FYDP-Group-31/PCBs/MCU_DAC_board/MCU_DAC_board.kicad_pcb

## KiCad design MCU_DAC_board/MCU_DAC_board.kicad_pcb (2025-07-11)

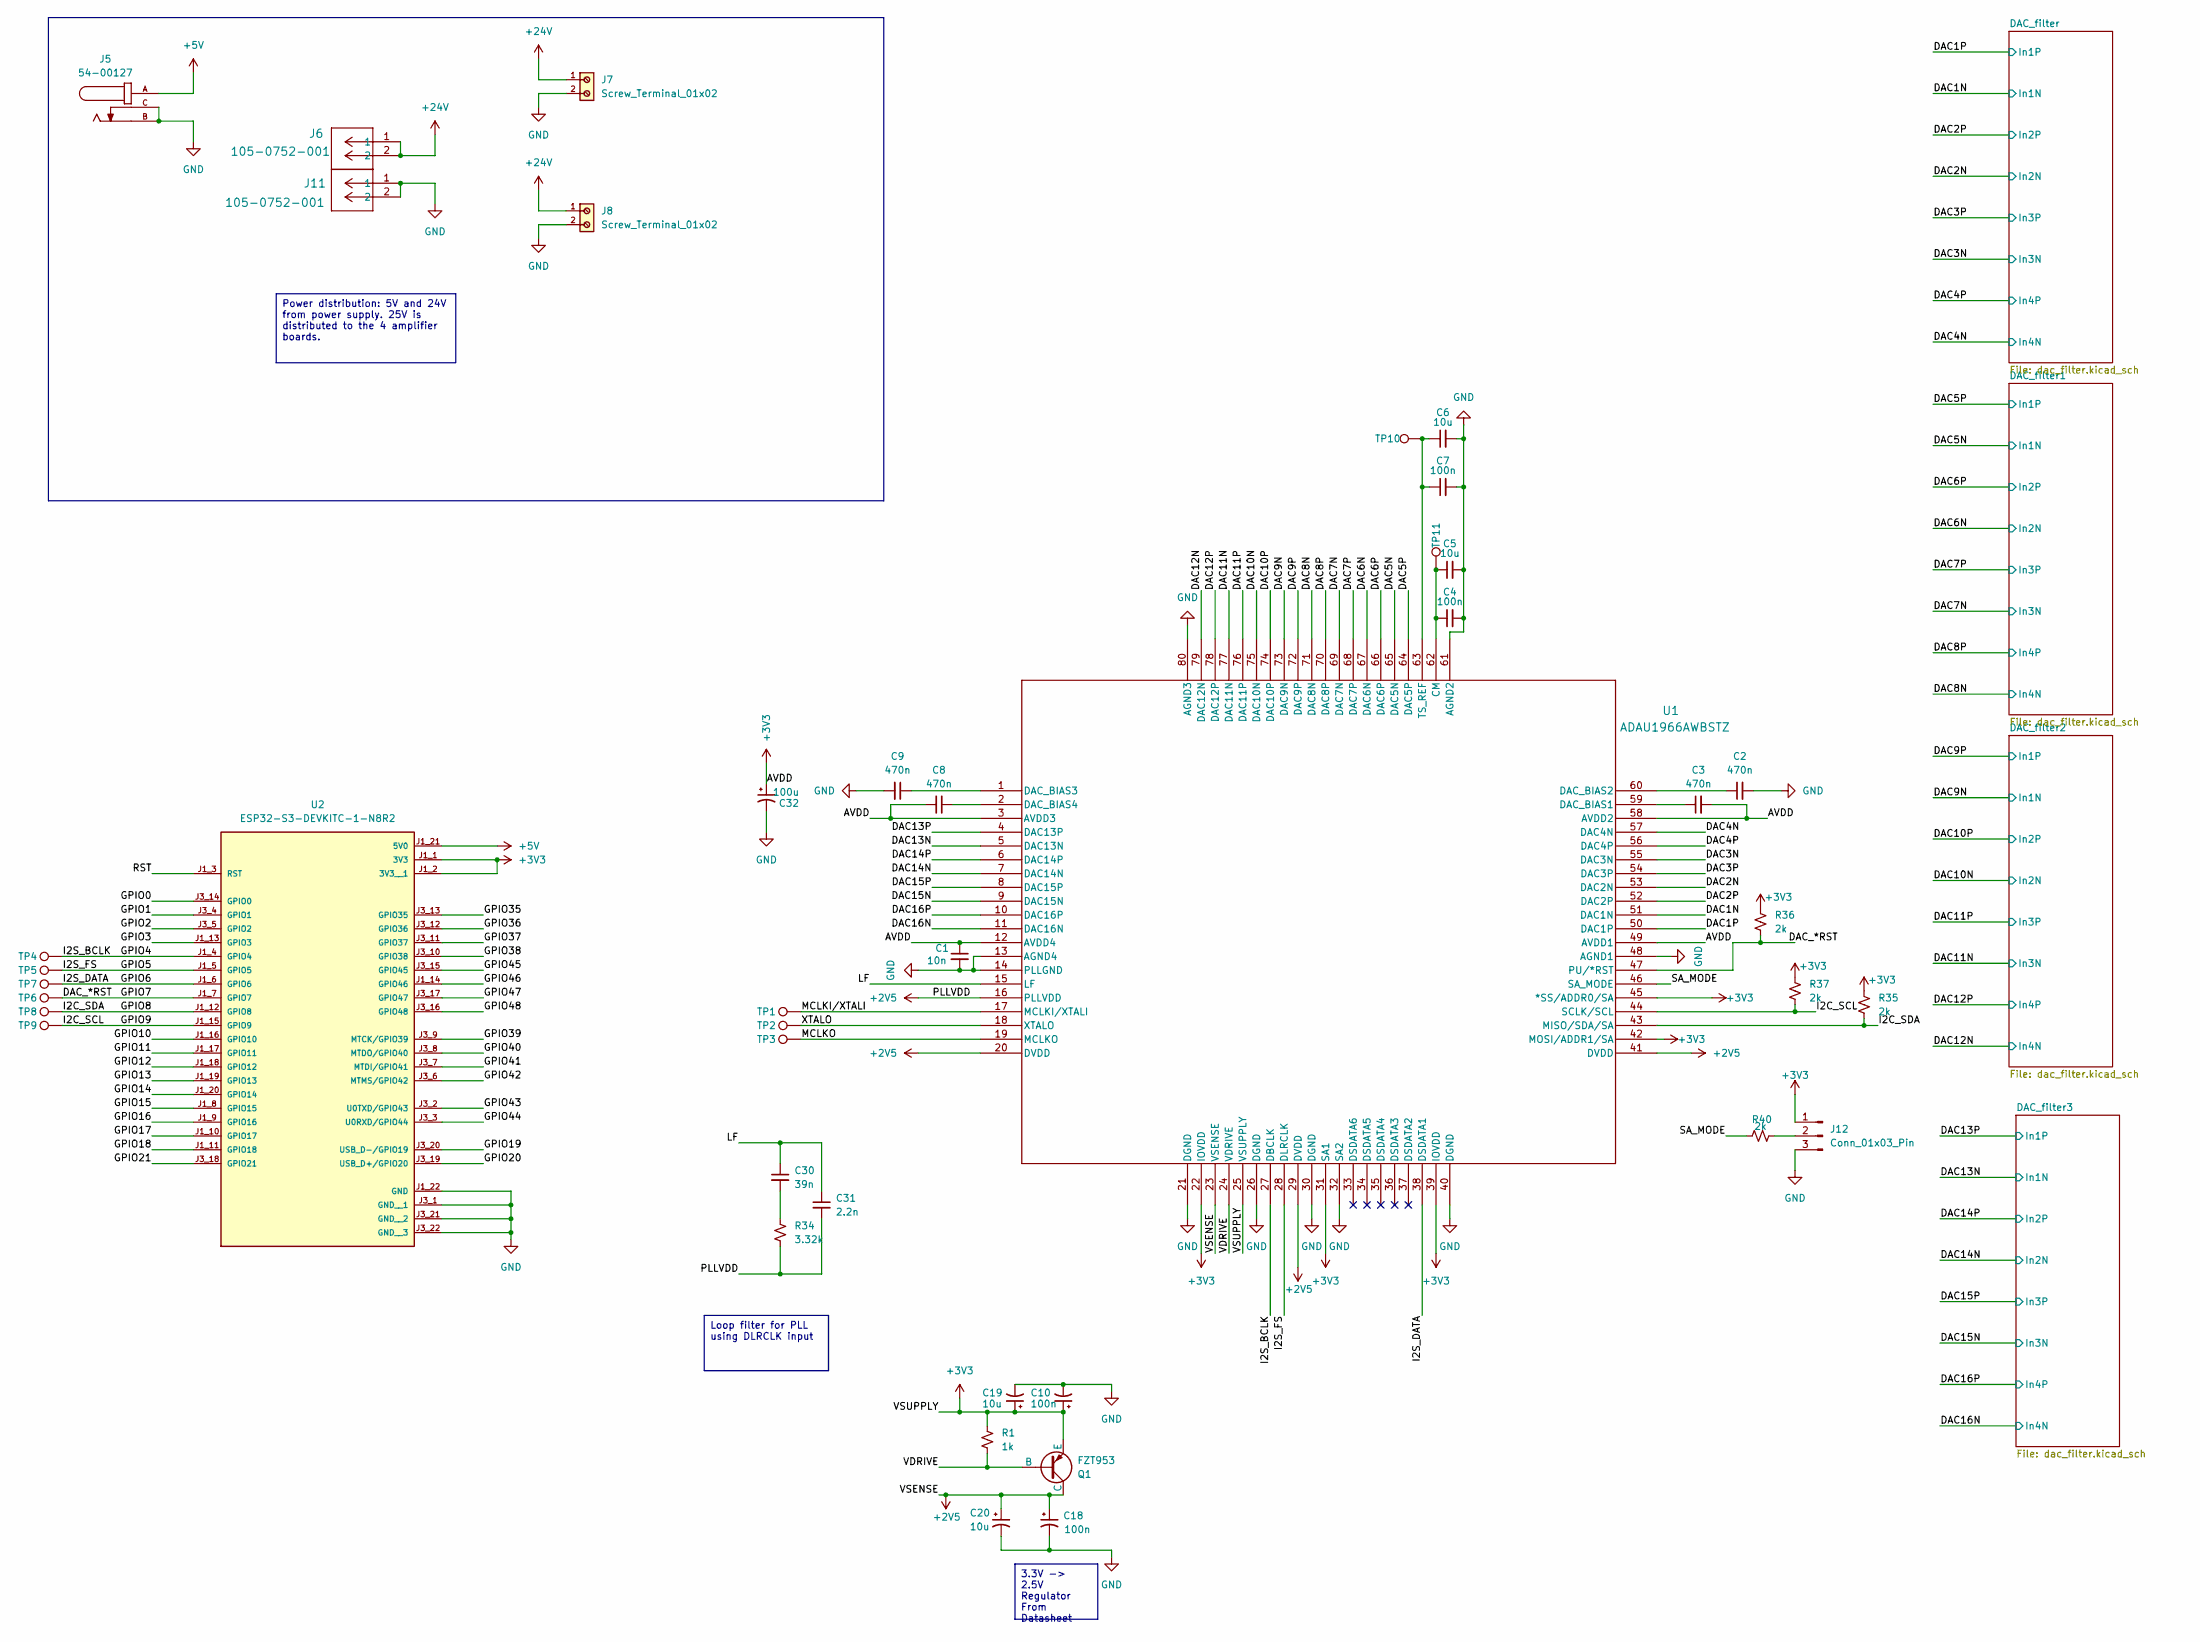
[picture p1: schematic MCU_DAC_board.kicad_sch]

Parts:
C1: 10n; C_0805_2012Metric_Pad1.18x1.45mm_HandSolder
C2, C3, C8, C9: 470n; C_0805_2012Metric_Pad1.18x1.45mm_HandSolder
C4, C7, C10, C18: 100n; C_0805_2012Metric_Pad1.18x1.45mm_HandSolder
C5, C6, C19, C20: 10u; C_0805_2012Metric_Pad1.18x1.45mm_HandSolder
C30: 39n; C_0805_2012Metric_Pad1.18x1.45mm_HandSolder
C31: 2.2n; C_0805_2012Metric_Pad1.18x1.45mm_HandSolder
C32: 100u; CP_Radial_D6.3mm_P2.50mm
J5: 54-00127; TENSILITY_54-00127; PARTREV A
J6, J11: 105-0752-001; CONN_0752-001
J7, J8: Screw_Terminal_01x02; 691137710002
J12: Conn_01x03_Pin; PinHeader_1x03_P2.54mm_Vertical
Q1: FZT953; SOT-223-3_TabPin2
R1: 1k; R_0805_2012Metric_Pad1.20x1.40mm_HandSolder
R34: 3.32k; R_0805_2012Metric_Pad1.20x1.40mm_HandSolder
R35, R36, R37, R40: 2k; R_0805_2012Metric_Pad1.20x1.40mm_HandSolder
TP1: MCLKI/XTALI; TP_1.8x1mm
TP2: XTALO; TP_1.8x1mm
TP3: MCLKO; TP_1.8x1mm
TP4: I2S_BCLK; TP_1.8x1mm
TP5: I2S_FS; TP_1.8x1mm
TP6: DAC_*RST; TP_1.8x1mm
TP7: I2S_DATA; TP_1.8x1mm
TP8: I2C_SDA; TP_1.8x1mm
TP9: I2C_SCL; TP_1.8x1mm
TP10: TS_REF; TP_1.8x1mm
TP11: CM; TP_1.8x1mm
U1: ADAU1966AWBSTZ; ST_80_2_ADI
U2: ESP32-S3-DEVKITC-1-N8R2; XCVR_ESP32-S3-DEVKITC-1-N8R2; PARTREV V1

Connections:
+2V5: C18.1, C20.1, C31.2, Q1.1 (C), R34.2, U1.16 (PLLVDD), U1.20 (DVDD), U1.23 (VSENSE), U1.29 (DVDD), U1.41 (DVDD)
+3V3: C1.1, C3.2, C8.2, C10.1, C19.1, C32.1, J12.1, Q1.3 (E), R1.1, R35.1, R36.1, R37.1, U1.3 (AVDD3), U1.12 (AVDD4), U1.22 (IOVDD), U1.25 (VSUPPLY), U1.31 (SA1), U1.39 (IOVDD), U1.42 (MOSI/ADDR1/SA), U1.45 (*SS/ADDR0/SA), U1.49 (AVDD1), U1.58 (AVDD2), U2.J1_1 (3V3), U2.J1_2 (3V3__1)
+5V: J5.A, U2.J1_21 (5V0)
+24V: J6.1, J6.2, J7.1, J8.1
/DAC1N: U1.51 (DAC1N); also elsewhere on the board
/DAC1P: U1.50 (DAC1P); also elsewhere on the board
/DAC2N: U1.53 (DAC2N); also elsewhere on the board
/DAC2P: U1.52 (DAC2P); also elsewhere on the board
/DAC3N: U1.55 (DAC3N); also elsewhere on the board
/DAC3P: U1.54 (DAC3P); also elsewhere on the board
/DAC4N: U1.57 (DAC4N); also elsewhere on the board
/DAC4P: U1.56 (DAC4P); also elsewhere on the board
/DAC5N: U1.65 (DAC5N); also elsewhere on the board
/DAC5P: U1.64 (DAC5P); also elsewhere on the board
/DAC6N: U1.67 (DAC6N); also elsewhere on the board
/DAC6P: U1.66 (DAC6P); also elsewhere on the board
/DAC7N: U1.69 (DAC7N); also elsewhere on the board
/DAC7P: U1.68 (DAC7P); also elsewhere on the board
/DAC8N: U1.71 (DAC8N); also elsewhere on the board
/DAC8P: U1.70 (DAC8P); also elsewhere on the board
/DAC9N: U1.73 (DAC9N); also elsewhere on the board
/DAC9P: U1.72 (DAC9P); also elsewhere on the board
/DAC10N: U1.75 (DAC10N); also elsewhere on the board
/DAC10P: U1.74 (DAC10P); also elsewhere on the board
/DAC11N: U1.77 (DAC11N); also elsewhere on the board
/DAC11P: U1.76 (DAC11P); also elsewhere on the board
/DAC12N: U1.79 (DAC12N); also elsewhere on the board
/DAC12P: U1.78 (DAC12P); also elsewhere on the board
/DAC13N: U1.5 (DAC13N); also elsewhere on the board
/DAC13P: U1.4 (DAC13P); also elsewhere on the board
/DAC14N: U1.7 (DAC14N); also elsewhere on the board
/DAC14P: U1.6 (DAC14P); also elsewhere on the board
/DAC15N: U1.9 (DAC15N); also elsewhere on the board
/DAC15P: U1.8 (DAC15P); also elsewhere on the board
/DAC16N: U1.11 (DAC16N); also elsewhere on the board
/DAC16P: U1.10 (DAC16P); also elsewhere on the board
/DAC_*RST: R36.2, TP6.1, U1.47 (PU/*RST), U2.J1_7 (GPIO7)
/GPIO0: U2.J3_14 (GPIO0)
/GPIO1: U2.J3_4 (GPIO1)
/GPIO2: U2.J3_5 (GPIO2)
/GPIO3: U2.J1_13 (GPIO3)
/GPIO4: TP4.1, U1.27 (DBCLK), U2.J1_4 (GPIO4)
/GPIO5: TP5.1, U1.28 (DLRCLK), U2.J1_5 (GPIO5)
/GPIO6: TP7.1, U1.38 (DSDATA1), U2.J1_6 (GPIO6)
/GPIO8: R35.2, TP8.1, U1.43 (MISO/SDA/SA), U2.J1_12 (GPIO8)
/GPIO9: R37.2, TP9.1, U1.44 (SCLK/SCL), U2.J1_15 (GPIO9)
/GPIO10: U2.J1_16 (GPIO10)
/GPIO11: U2.J1_17 (GPIO11)
/GPIO12: U2.J1_18 (GPIO12)
/GPIO13: U2.J1_19 (GPIO13)
/GPIO14: U2.J1_20 (GPIO14)
/GPIO15: U2.J1_8 (GPIO15)
/GPIO16: U2.J1_9 (GPIO16)
/GPIO17: U2.J1_10 (GPIO17)
/GPIO18: U2.J1_11 (GPIO18)
/GPIO19: U2.J3_20 (USB_D-/GPIO19)
/GPIO20: U2.J3_19 (USB_D+/GPIO20)
/GPIO21: U2.J3_18 (GPIO21)
/GPIO35: U2.J3_13 (GPIO35)
/GPIO36: U2.J3_12 (GPIO36)
/GPIO37: U2.J3_11 (GPIO37)
/GPIO38: U2.J3_10 (GPIO38)
/GPIO39: U2.J3_9 (MTCK/GPIO39)
/GPIO40: U2.J3_8 (MTDO/GPIO40)
/GPIO41: U2.J3_7 (MTDI/GPIO41)
/GPIO42: U2.J3_6 (MTMS/GPIO42)
/GPIO43: U2.J3_2 (U0TXD/GPIO43)
/GPIO44: U2.J3_3 (U0RXD/GPIO44)
/GPIO45: U2.J3_15 (GPIO45)
/GPIO46: U2.J1_14 (GPIO46)
/GPIO47: U2.J3_17 (GPIO47)
/GPIO48: U2.J3_16 (GPIO48)
/LF: C30.1, C31.1, U1.15 (LF)
/MCLKI/XTALI: TP1.1, U1.17 (MCLKI/XTALI)
/MCLKO: TP3.1, U1.19 (MCLKO)
/RST: U2.J1_3 (RST)
/SA_MODE: R40.1, U1.46 (SA_MODE)
/VDRIVE: Q1.2 (B), R1.2, U1.24 (VDRIVE)
/XTALO: TP2.1, U1.18 (XTALO)
GND: C1.2, C2.2, C4.2, C5.2, C6.2, C7.2, C9.2, C10.2, C18.2, C19.2, C20.2, C32.2, J5.B, J5.C, J7.2, J8.2, J11.1, J11.2, J12.3, U1.13 (AGND4), U1.14 (PLLGND), U1.21 (DGND), U1.26 (DGND), U1.30 (DGND), U1.32 (SA2), U1.40 (DGND), U1.48 (AGND1), U1.61 (AGND2), U1.80 (AGND3), U2.J1_22 (GND), U2.J3_1 (GND__1), U2.J3_21 (GND__2), U2.J3_22 (GND__3)
unnamed: C30.2, R34.1
unnamed: J12.2, R40.2
unnamed: C4.1, C5.1, TP11.1, U1.62 (CM)
unnamed: C3.1, U1.59 (DAC_BIAS1)
unnamed: C2.1, U1.60 (DAC_BIAS2)
unnamed: C9.1, U1.1 (DAC_BIAS3)
unnamed: C8.1, U1.2 (DAC_BIAS4)
unnamed: C6.1, C7.1, TP10.1, U1.63 (TS_REF)

Notes on the sheet:
3.3V -> 2.5V Regulator From Datasheet
Loop filter for PLL using DLRCLK input
Power distribution: 5V and 24V from power supply. 25V is distributed to the 4 amplifier boards.

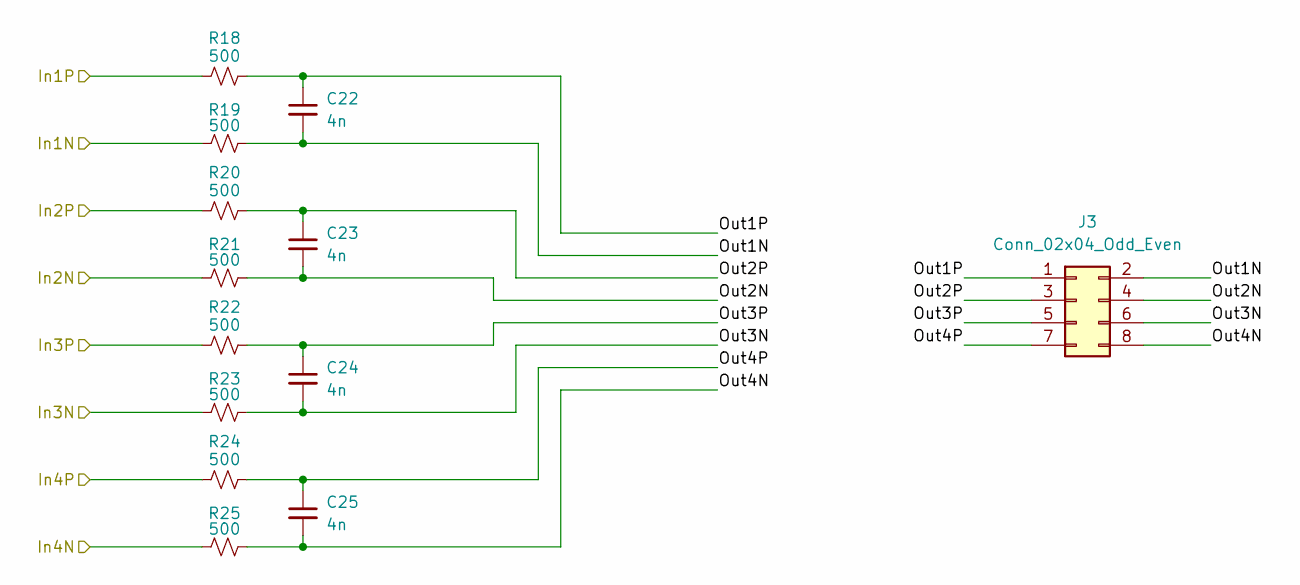
[picture p2: schematic dac_filter.kicad_sch]

Parts:
C22, C23, C24, C25: 4n; C_0805_2012Metric_Pad1.18x1.45mm_HandSolder
J3: Conn_02x04_Odd_Even; BHR-08-VUA
R18, R19, R20, R21, R22, R23, R24, R25: 500; R_0805_2012Metric_Pad1.20x1.40mm_HandSolder

Connections:
/DAC9N: R19.1; also elsewhere on the board
/DAC9P: R18.1; also elsewhere on the board
/DAC10N: R21.1; also elsewhere on the board
/DAC10P: R20.1; also elsewhere on the board
/DAC11N: R23.1; also elsewhere on the board
/DAC11P: R22.1; also elsewhere on the board
/DAC12N: R25.1; also elsewhere on the board
/DAC12P: R24.1; also elsewhere on the board
/DAC_filter2/Out1N: C22.2, J3.2, R19.2
/DAC_filter2/Out1P: C22.1, J3.1, R18.2
/DAC_filter2/Out2N: C23.2, J3.4, R21.2
/DAC_filter2/Out2P: C23.1, J3.3, R20.2
/DAC_filter2/Out3N: C24.2, J3.6, R23.2
/DAC_filter2/Out3P: C24.1, J3.5, R22.2
/DAC_filter2/Out4N: C25.2, J3.8, R25.2
/DAC_filter2/Out4P: C25.1, J3.7, R24.2

Parts of its further copies:
C11, C12, C13, C14, C15, C16, C17, C21, C26, C27, C28, C29: 4n; C_0805_2012Metric_Pad1.18x1.45mm_HandSolder
J1, J2, J4: Conn_02x04_Odd_Even; BHR-08-VUA
R2, R3, R4, R5, R6, R7, R8, R9, R10, R11, R12, R13, R14, R15, R16, R17, R26, R27, R28, R29, R30, R31, R32, R33: 500; R_0805_2012Metric_Pad1.20x1.40mm_HandSolder

Connections of its further copies:
/DAC1N: R3.1; also elsewhere on the board
/DAC1P: R2.1; also elsewhere on the board
/DAC2N: R5.1; also elsewhere on the board
/DAC2P: R4.1; also elsewhere on the board
/DAC3N: R7.1; also elsewhere on the board
/DAC3P: R6.1; also elsewhere on the board
/DAC4N: R9.1; also elsewhere on the board
/DAC4P: R8.1; also elsewhere on the board
/DAC5N: R11.1; also elsewhere on the board
/DAC5P: R10.1; also elsewhere on the board
/DAC6N: R13.1; also elsewhere on the board
/DAC6P: R12.1; also elsewhere on the board
/DAC7N: R15.1; also elsewhere on the board
/DAC7P: R14.1; also elsewhere on the board
/DAC8N: R17.1; also elsewhere on the board
/DAC8P: R16.1; also elsewhere on the board
/DAC13N: R27.1; also elsewhere on the board
/DAC13P: R26.1; also elsewhere on the board
/DAC14N: R29.1; also elsewhere on the board
/DAC14P: R28.1; also elsewhere on the board
/DAC15N: R31.1; also elsewhere on the board
/DAC15P: R30.1; also elsewhere on the board
/DAC16N: R33.1; also elsewhere on the board
/DAC16P: R32.1; also elsewhere on the board
/DAC_filter1/Out1N: C15.2, J2.2, R11.2
/DAC_filter1/Out1P: C15.1, J2.1, R10.2
/DAC_filter1/Out2N: C16.2, J2.4, R13.2
/DAC_filter1/Out2P: C16.1, J2.3, R12.2
/DAC_filter1/Out3N: C17.2, J2.6, R15.2
/DAC_filter1/Out3P: C17.1, J2.5, R14.2
/DAC_filter1/Out4N: C21.2, J2.8, R17.2
/DAC_filter1/Out4P: C21.1, J2.7, R16.2
/DAC_filter3/Out1N: C26.2, J4.2, R27.2
/DAC_filter3/Out1P: C26.1, J4.1, R26.2
/DAC_filter3/Out2N: C27.2, J4.4, R29.2
/DAC_filter3/Out2P: C27.1, J4.3, R28.2
/DAC_filter3/Out3N: C28.2, J4.6, R31.2
/DAC_filter3/Out3P: C28.1, J4.5, R30.2
/DAC_filter3/Out4N: C29.2, J4.8, R33.2
/DAC_filter3/Out4P: C29.1, J4.7, R32.2
/DAC_filter/Out1N: C11.2, J1.2, R3.2
/DAC_filter/Out1P: C11.1, J1.1, R2.2
/DAC_filter/Out2N: C12.2, J1.4, R5.2
/DAC_filter/Out2P: C12.1, J1.3, R4.2
/DAC_filter/Out3N: C13.2, J1.6, R7.2
/DAC_filter/Out3P: C13.1, J1.5, R6.2
/DAC_filter/Out4N: C14.2, J1.8, R9.2
/DAC_filter/Out4P: C14.1, J1.7, R8.2

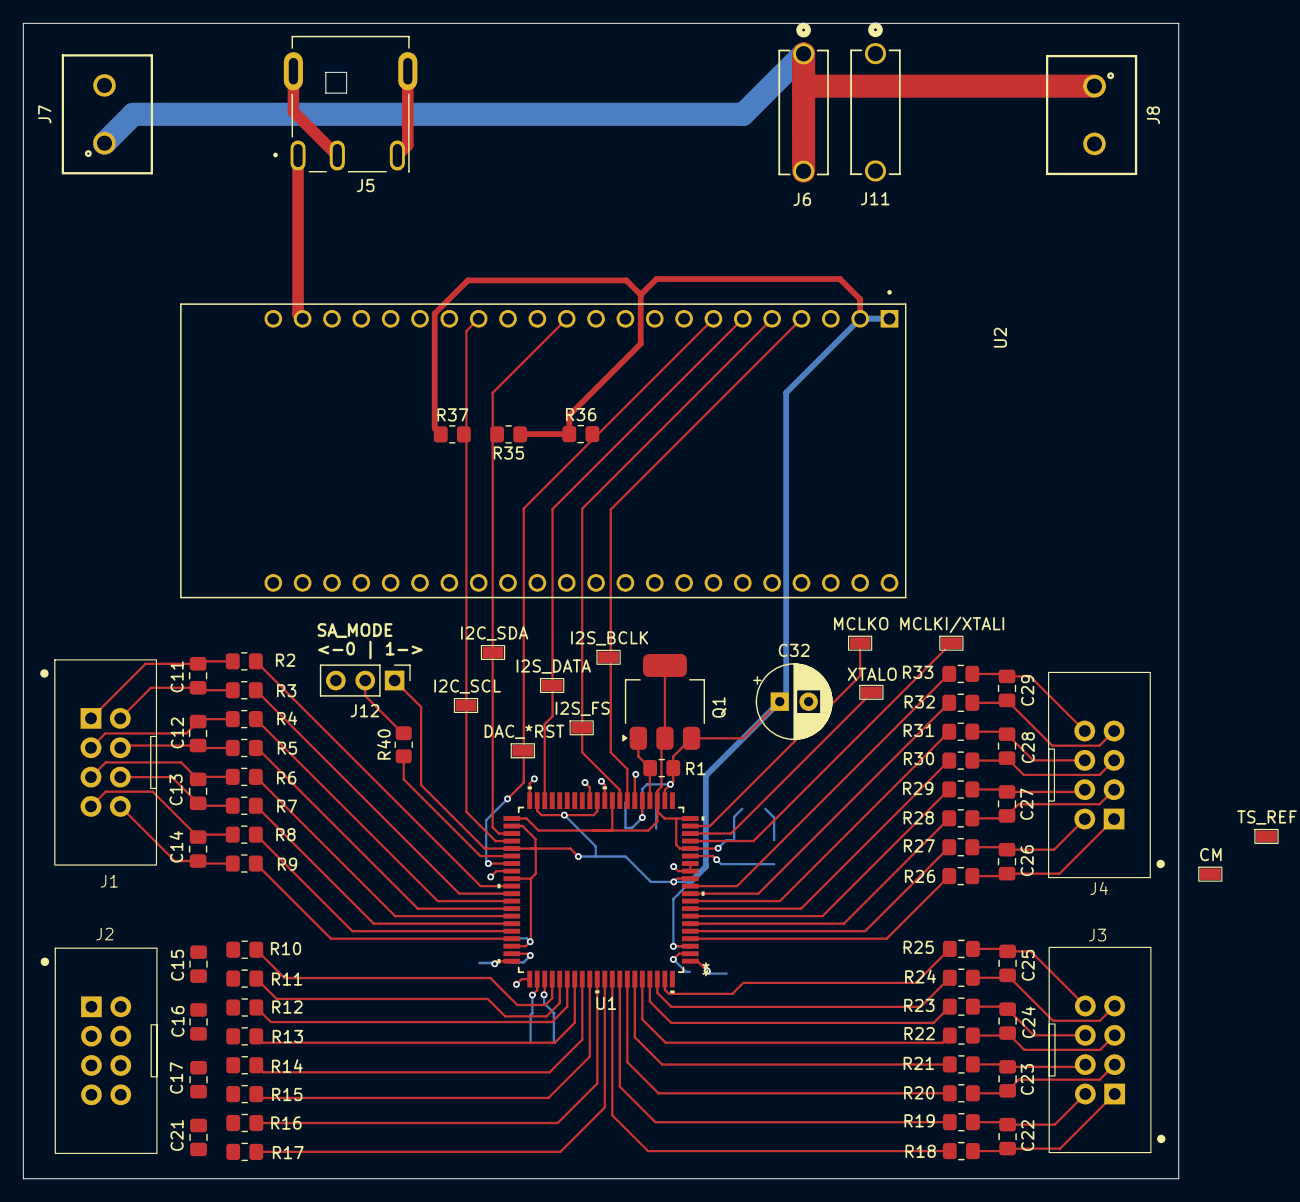
[picture p3: board MCU_DAC_board.kicad_pcb from above]

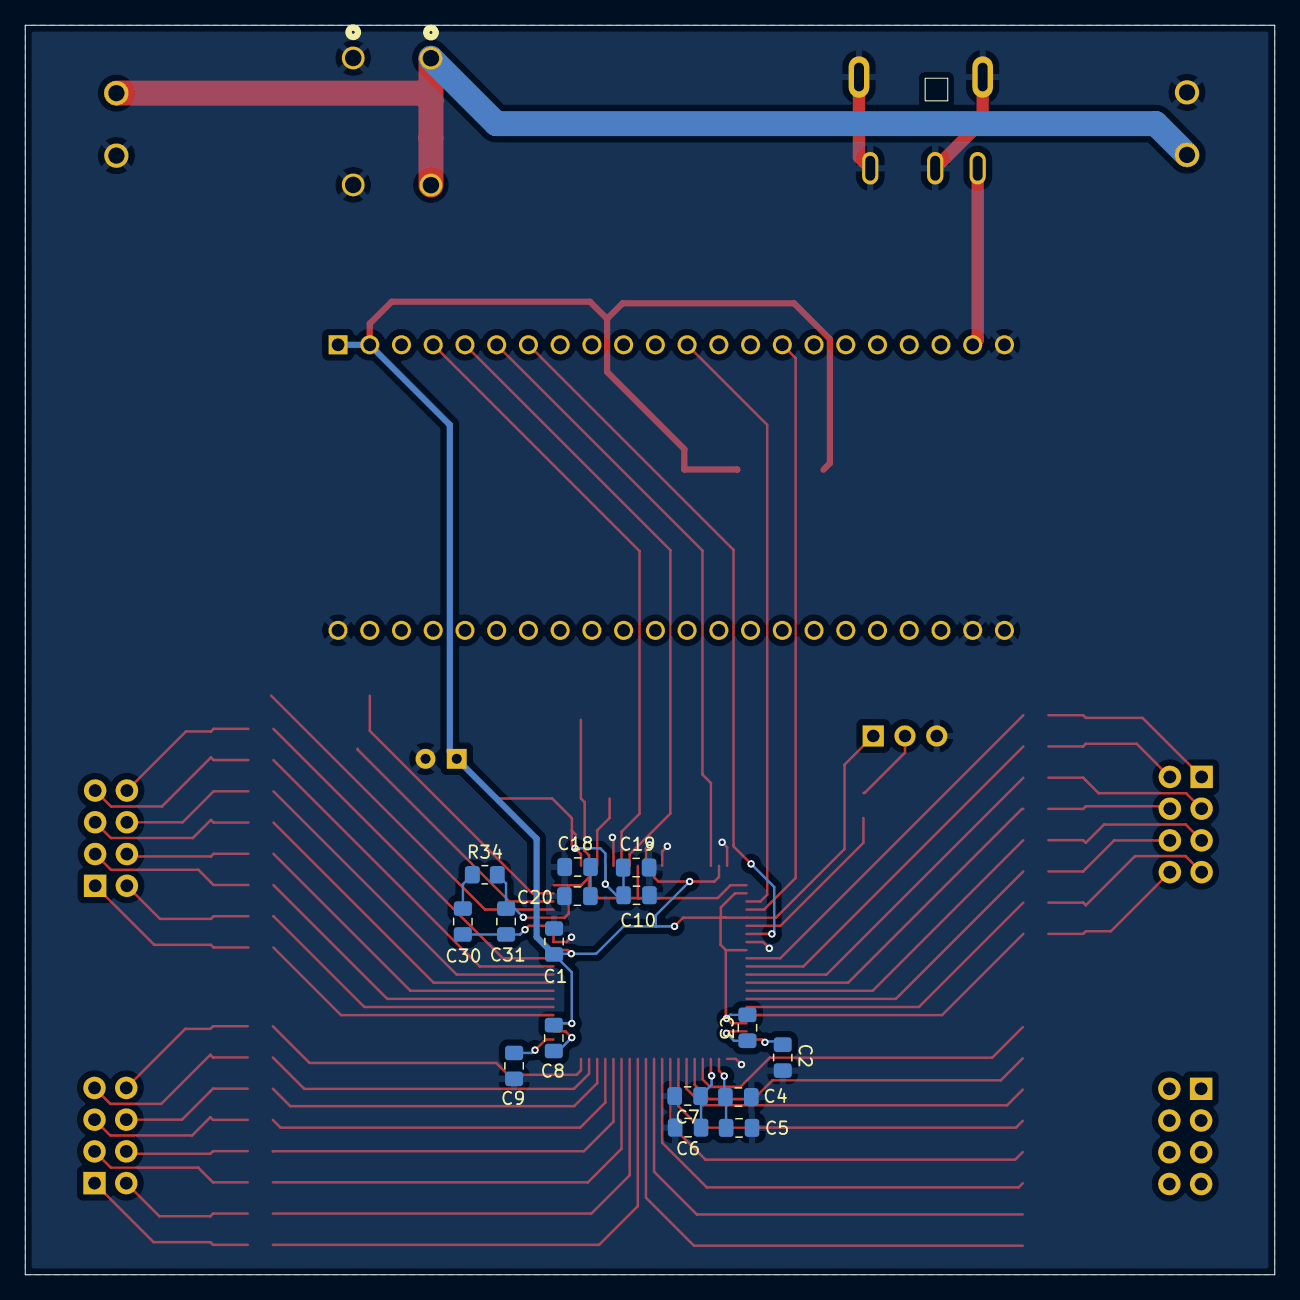
[picture p4: board MCU_DAC_board.kicad_pcb from below]

Board: 2 copper layers, 100.0 x 100.0 mm, 94 parts (16 on the bottom side), 89 nets.
