FYDP-Group-31/PCBs/Amplifier_board/Amplifier_board.kicad_pcb

## KiCad design Amplifier_board/Amplifier_board.kicad_pcb (2025-07-10)

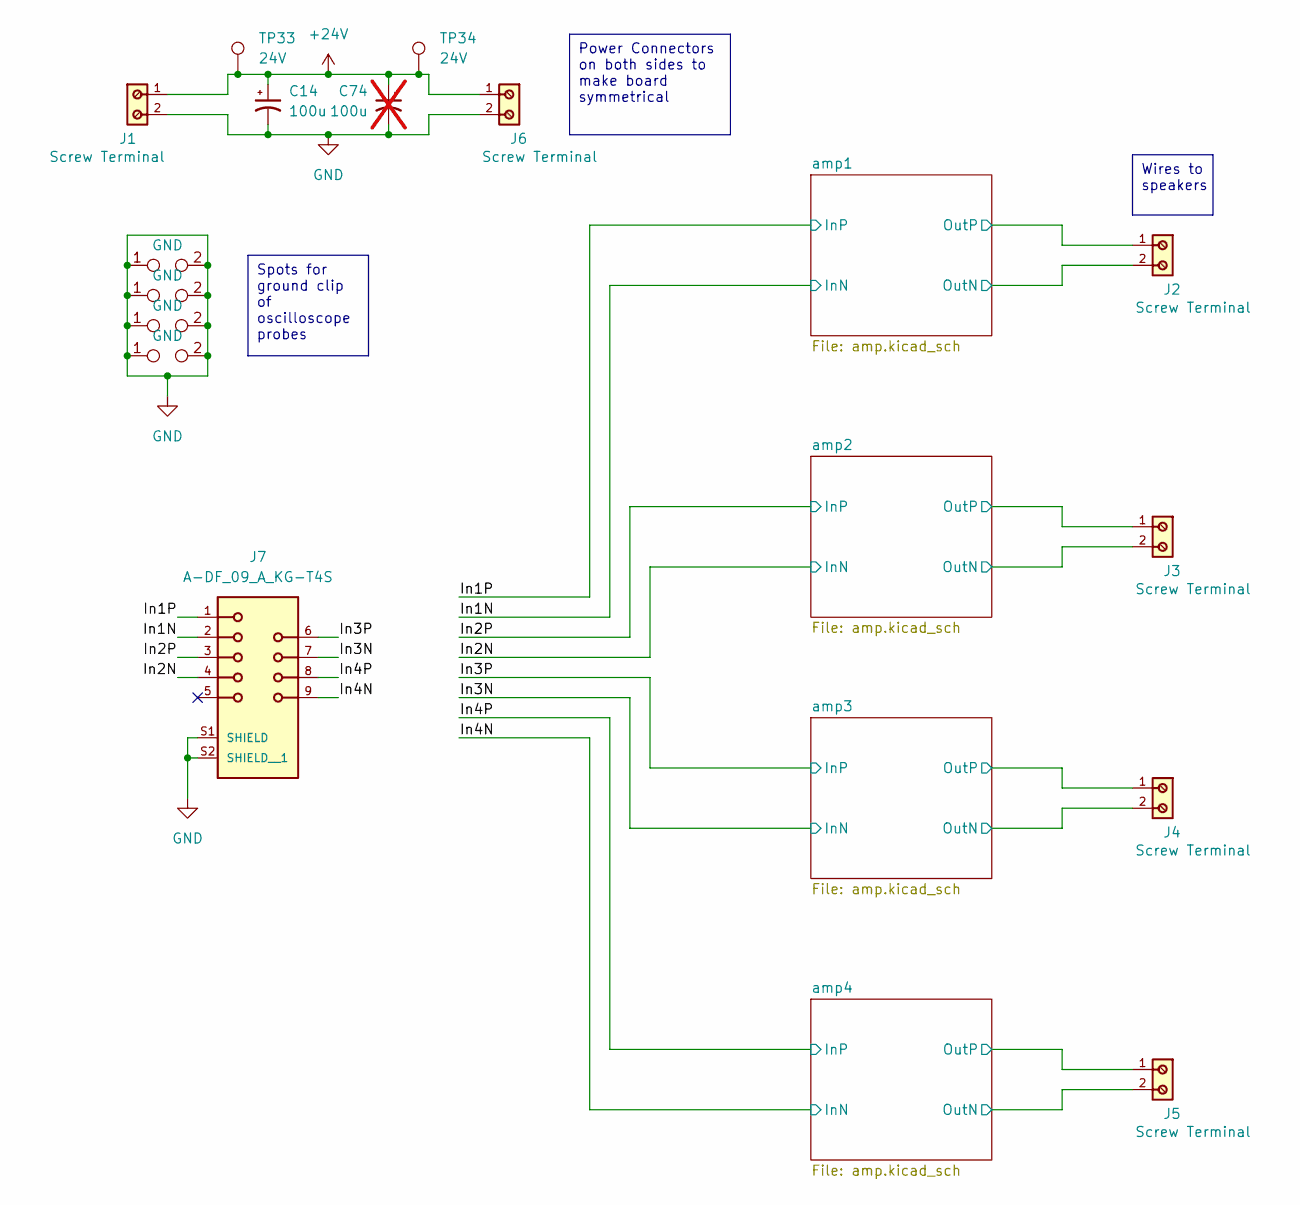
[picture p5: schematic Amplifier_board.kicad_sch]

Parts:
C14: 100u; CP_Radial_D6.3mm_P2.50mm
C74: 100u; CP_Radial_D6.3mm_P2.50mm; not fitted
J1, J2, J3, J4, J5, J6: Screw Terminal; 691137710002
J7: A-DF_09_A_KG-T4S; ASSMANN_A-DF_09_A_KG-T4S; PARTREV 05
TP33, TP34: 24V; TP_RCUCTE
TP35, TP36, TP37, TP38: GND; TestPoint_Bridge_Pitch5.08mm_Drill0.7mm

Connections:
+24V: C14.1, C74.1, J1.1, J6.1, TP33.1, TP34.1; also elsewhere on the board
/In1N: J7.2; also elsewhere on the board
/In1P: J7.1; also elsewhere on the board
/In2N: J7.4; also elsewhere on the board
/In2P: J7.3; also elsewhere on the board
/In3N: J7.7; also elsewhere on the board
/In3P: J7.6; also elsewhere on the board
/In4N: J7.9; also elsewhere on the board
/In4P: J7.8; also elsewhere on the board
/amp1/OutN: J2.2; also elsewhere on the board
/amp1/OutP: J2.1; also elsewhere on the board
/amp2/OutN: J3.2; also elsewhere on the board
/amp2/OutP: J3.1; also elsewhere on the board
/amp3/OutN: J4.2; also elsewhere on the board
/amp3/OutP: J4.1; also elsewhere on the board
/amp4/OutN: J5.2; also elsewhere on the board
/amp4/OutP: J5.1; also elsewhere on the board
GND: C14.2, C74.2, J1.2, J6.2, J7.S1 (SHIELD), J7.S2 (SHIELD__1), TP35.1, TP35.2, TP36.1, TP36.2, TP37.1, TP37.2, TP38.1, TP38.2; also elsewhere on the board

Notes on the sheet:
Wires to speakers
Spots for ground clip of oscilloscope probes
Power Connectors on both sides to make board symmetrical

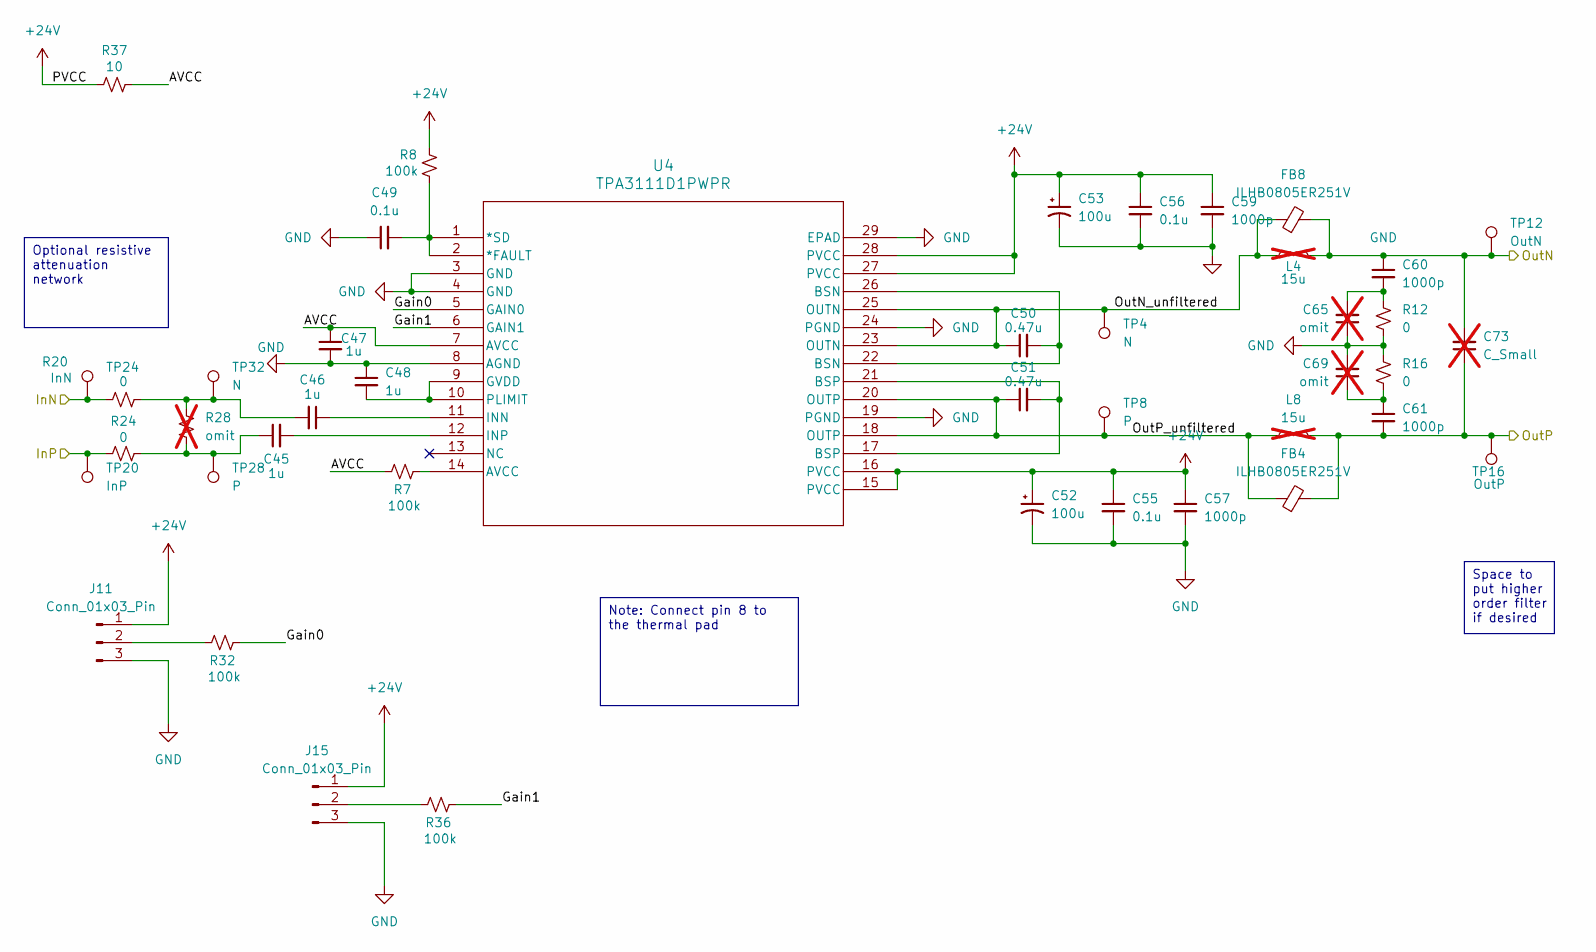
[picture p6: schematic amp.kicad_sch]

Parts:
C45, C46, C47, C48: 1u; C_0805_2012Metric_Pad1.18x1.45mm_HandSolder
C49, C55, C56: 0.1u; C_0805_2012Metric_Pad1.18x1.45mm_HandSolder
C50, C51: 0.47u; C_0805_2012Metric_Pad1.18x1.45mm_HandSolder
C52, C53: 100u; CP_Radial_D6.3mm_P2.50mm
C57, C59, C60, C61: 1000p; C_0805_2012Metric_Pad1.18x1.45mm_HandSolder
C65, C69: omit; C_0805_2012Metric_Pad1.18x1.45mm_HandSolder; not fitted
C73: C_Small; C_0805_2012Metric_Pad1.18x1.45mm_HandSolder; not fitted
FB4, FB8: ILHB0805ER251V; L_0805_2012Metric_Pad1.15x1.40mm_HandSolder
J11, J15: Conn_01x03_Pin; PinSocket_1x03_P2.54mm_Vertical
L4, L8: 15u; L_Taiyo-Yuden_NR-50xx_HandSoldering; not fitted
R7, R8, R32, R36: 100k; R_0805_2012Metric_Pad1.20x1.40mm_HandSolder
R12, R16, R20, R24: 0; R_0805_2012Metric_Pad1.20x1.40mm_HandSolder
R28: omit; R_0805_2012Metric_Pad1.20x1.40mm_HandSolder; not fitted
R37: 10; C_0805_2012Metric_Pad1.18x1.45mm_HandSolder
TP4, TP32: N; TP_RCUCTE
TP8, TP28: P; TP_RCUCTE
TP12: OutN; TP_RCUCTE
TP16: OutP; TP_RCUCTE
TP20: InP; TP_RCUCTE
TP24: InN; TP_RCUCTE
U4: TPA3111D1PWPR; PWP28_6P17X2P4

Connections:
+24V: C52.1, C53.1, C55.1, C56.1, C57.1, C59.1, J11.1, J15.1, R8.1, R37.1, U4.15 (PVCC), U4.16 (PVCC), U4.27 (PVCC), U4.28 (PVCC); also elsewhere on the board
/In4N: R20.2, TP24.1; also elsewhere on the board
/In4P: R24.2, TP20.1; also elsewhere on the board
/amp4/Gain0: R32.2, U4.5 (GAIN0)
/amp4/Gain1: R36.2, U4.6 (GAIN1)
/amp4/OutN: C60.1, C73.2, FB8.2, L4.2, TP12.1; also elsewhere on the board
/amp4/OutN_unfiltered: C50.1, FB8.1, L4.1, TP4.1, U4.23 (OUTN), U4.25 (OUTN)
/amp4/OutP: C61.2, C73.1, FB4.2, L8.2, TP16.1; also elsewhere on the board
/amp4/OutP_unfiltered: C51.1, FB4.1, L8.1, TP8.1, U4.18 (OUTP), U4.20 (OUTP)
GND: C47.2, C48.1, C49.1, C52.2, C53.2, C55.2, C56.2, C57.2, C59.2, C65.1, C69.2, J11.3, J15.3, R12.1, R16.2, U4.3 (GND), U4.4 (GND), U4.8 (AGND), U4.19 (PGND), U4.24 (PGND), U4.29 (EPAD); also elsewhere on the board
unnamed: C45.1, R24.1, R28.2, TP28.1
unnamed: C46.2, R20.1, R28.1, TP32.1
unnamed: C50.2, U4.22 (BSN), U4.26 (BSN)
unnamed: C51.2, U4.17 (BSP), U4.21 (BSP)
unnamed: C60.2, C65.2, R12.2
unnamed: C61.1, C69.1, R16.1
unnamed: J11.2, R32.1
unnamed: J15.2, R36.1
unnamed: R7.2, U4.14 (AVCC)
unnamed: C49.2, R8.2, U4.1 (*SD), U4.2 (*FAULT)
unnamed: C48.2, U4.9 (GVDD), U4.10 (PLIMIT)
unnamed: C46.1, U4.11 (INN)
unnamed: C45.2, U4.12 (INP)

Parts of its further copies:
C1, C2, C3, C4, C15, C16, C17, C18, C30, C31, C32, C33: 1u; C_0805_2012Metric_Pad1.18x1.45mm_HandSolder
C5, C10, C11, C19, C24, C25, C34, C39, C40: 0.1u; C_0805_2012Metric_Pad1.18x1.45mm_HandSolder
C6, C7, C20, C21, C35, C36: 0.47u; C_0805_2012Metric_Pad1.18x1.45mm_HandSolder
C8, C9, C22, C23, C37, C38: 100u; CP_Radial_D6.3mm_P2.50mm
C12, C13, C26, C27, C28, C29, C41, C42, C43, C44, C54, C58: 1000p; C_0805_2012Metric_Pad1.18x1.45mm_HandSolder
C62, C63, C64, C66, C67, C68: omit; C_0805_2012Metric_Pad1.18x1.45mm_HandSolder; not fitted
C70, C71, C72: C_Small; C_0805_2012Metric_Pad1.18x1.45mm_HandSolder; not fitted
FB1, FB2, FB3, FB5, FB6, FB7: ILHB0805ER251V; L_0805_2012Metric_Pad1.15x1.40mm_HandSolder
J8, J9, J10, J12, J13, J14: Conn_01x03_Pin; PinSocket_1x03_P2.54mm_Vertical
L1, L2, L3, L5, L6, L7: 15u; L_Taiyo-Yuden_NR-50xx_HandSoldering; not fitted
R1, R2, R3, R4, R5, R6, R29, R30, R31, R33, R34, R35: 100k; R_0805_2012Metric_Pad1.20x1.40mm_HandSolder
R9, R10, R11, R13, R14, R15, R17, R18, R19, R21, R22, R23: 0; R_0805_2012Metric_Pad1.20x1.40mm_HandSolder
R25, R26, R27: omit; R_0805_2012Metric_Pad1.20x1.40mm_HandSolder; not fitted
R38, R39, R40: 10; C_0805_2012Metric_Pad1.18x1.45mm_HandSolder
TP1, TP2, TP3, TP29, TP30, TP31: N; TP_RCUCTE
TP5, TP6, TP7, TP25, TP26, TP27: P; TP_RCUCTE
TP9, TP10, TP11: OutN; TP_RCUCTE
TP13, TP14, TP15: OutP; TP_RCUCTE
TP17, TP18, TP19: InP; TP_RCUCTE
TP21, TP22, TP23: InN; TP_RCUCTE
U1, U2, U3: TPA3111D1PWPR; PWP28_6P17X2P4

Connections of its further copies:
+24V: C8.1, C9.1, C10.1, C11.1, C12.1, C13.1, C22.1, C23.1, C24.1, C25.1, C26.1, C27.1, C37.1, C38.1, C39.1, C40.1, C41.1, C42.1, J8.1, J9.1, J10.1, J12.1, J13.1, J14.1, R2.1, R4.1, R6.1, R38.1, R39.1, R40.1, U1.15 (PVCC), U1.16 (PVCC), U1.27 (PVCC), U1.28 (PVCC), U2.15 (PVCC), U2.16 (PVCC), U2.27 (PVCC), U2.28 (PVCC), U3.15 (PVCC), U3.16 (PVCC), U3.27 (PVCC), U3.28 (PVCC); also elsewhere on the board
/In1N: R17.2, TP21.1; also elsewhere on the board
/In1P: R21.2, TP17.1; also elsewhere on the board
/In2N: R18.2, TP22.1; also elsewhere on the board
/In2P: R22.2, TP18.1; also elsewhere on the board
/In3N: R19.2, TP23.1; also elsewhere on the board
/In3P: R23.2, TP19.1; also elsewhere on the board
/amp1/Gain0: R29.2, U1.5 (GAIN0)
/amp1/Gain1: R33.2, U1.6 (GAIN1)
/amp1/OutN: C54.1, C70.2, FB5.2, L1.2, TP9.1; also elsewhere on the board
/amp1/OutN_unfiltered: C6.1, FB5.1, L1.1, TP1.1, U1.23 (OUTN), U1.25 (OUTN)
/amp1/OutP: C58.2, C70.1, FB1.2, L5.2, TP13.1; also elsewhere on the board
/amp1/OutP_unfiltered: C7.1, FB1.1, L5.1, TP5.1, U1.18 (OUTP), U1.20 (OUTP)
/amp2/AVCC: C17.1, R3.1, R38.2, U2.7 (AVCC)
/amp2/Gain0: R30.2, U2.5 (GAIN0)
/amp2/Gain1: R34.2, U2.6 (GAIN1)
/amp2/OutN: C28.1, C71.2, FB6.2, L2.2, TP10.1; also elsewhere on the board
/amp2/OutN_unfiltered: C20.1, FB6.1, L2.1, TP2.1, U2.23 (OUTN), U2.25 (OUTN)
/amp2/OutP: C29.2, C71.1, FB2.2, L6.2, TP14.1; also elsewhere on the board
/amp2/OutP_unfiltered: C21.1, FB2.1, L6.1, TP6.1, U2.18 (OUTP), U2.20 (OUTP)
/amp3/AVCC: C32.1, R5.1, R39.2, U3.7 (AVCC)
/amp3/Gain0: R31.2, U3.5 (GAIN0)
/amp3/Gain1: R35.2, U3.6 (GAIN1)
/amp3/OutN: C43.1, C72.2, FB7.2, L3.2, TP11.1; also elsewhere on the board
/amp3/OutN_unfiltered: C35.1, FB7.1, L3.1, TP3.1, U3.23 (OUTN), U3.25 (OUTN)
/amp3/OutP: C44.2, C72.1, FB3.2, L7.2, TP15.1; also elsewhere on the board
/amp3/OutP_unfiltered: C36.1, FB3.1, L7.1, TP7.1, U3.18 (OUTP), U3.20 (OUTP)
GND: C3.2, C4.1, C5.1, C8.2, C9.2, C10.2, C11.2, C12.2, C13.2, C17.2, C18.1, C19.1, C22.2, C23.2, C24.2, C25.2, C26.2, C27.2, C32.2, C33.1, C34.1, C37.2, C38.2, C39.2, C40.2, C41.2, C42.2, C62.1, C63.1, C64.1, C66.2, C67.2, C68.2, J8.3, J9.3, J10.3, J12.3, J13.3, J14.3, R9.1, R10.1, R11.1, R13.2, R14.2, R15.2, U1.3 (GND), U1.4 (GND), U1.8 (AGND), U1.19 (PGND), U1.24 (PGND), U1.29 (EPAD), U2.3 (GND), U2.4 (GND), U2.8 (AGND), U2.19 (PGND), U2.24 (PGND), U2.29 (EPAD), U3.3 (GND), U3.4 (GND), U3.8 (AGND), U3.19 (PGND), U3.24 (PGND), U3.29 (EPAD); also elsewhere on the board
unnamed: C1.1, R21.1, R25.2, TP25.1
unnamed: C2.2, R17.1, R25.1, TP29.1
unnamed: C6.2, U1.22 (BSN), U1.26 (BSN)
unnamed: C7.2, U1.17 (BSP), U1.21 (BSP)
unnamed: C15.1, R22.1, R26.2, TP26.1
unnamed: C16.2, R18.1, R26.1, TP30.1
unnamed: C20.2, U2.22 (BSN), U2.26 (BSN)
unnamed: C21.2, U2.17 (BSP), U2.21 (BSP)
unnamed: C28.2, C63.2, R10.2
unnamed: C29.1, C67.1, R14.1
unnamed: C30.1, R23.1, R27.2, TP27.1
unnamed: C31.2, R19.1, R27.1, TP31.1
unnamed: C35.2, U3.22 (BSN), U3.26 (BSN)
unnamed: C36.2, U3.17 (BSP), U3.21 (BSP)
unnamed: C43.2, C64.2, R11.2
unnamed: C44.1, C68.1, R15.1
unnamed: C54.2, C62.2, R9.2
unnamed: C58.1, C66.1, R13.1
unnamed: J8.2, R29.1
unnamed: J9.2, R30.1
unnamed: J10.2, R31.1
unnamed: J12.2, R33.1
unnamed: J13.2, R34.1
unnamed: J14.2, R35.1
unnamed: R1.2, U1.14 (AVCC)
unnamed: R3.2, U2.14 (AVCC)
unnamed: R5.2, U3.14 (AVCC)
unnamed: C5.2, R2.2, U1.1 (*SD), U1.2 (*FAULT)
unnamed: C4.2, U1.9 (GVDD), U1.10 (PLIMIT)
unnamed: C2.1, U1.11 (INN)
unnamed: C1.2, U1.12 (INP)
unnamed: C19.2, R4.2, U2.1 (*SD), U2.2 (*FAULT)
unnamed: C18.2, U2.9 (GVDD), U2.10 (PLIMIT)
unnamed: C16.1, U2.11 (INN)
unnamed: C15.2, U2.12 (INP)
unnamed: C34.2, R6.2, U3.1 (*SD), U3.2 (*FAULT)
unnamed: C33.2, U3.9 (GVDD), U3.10 (PLIMIT)
unnamed: C31.1, U3.11 (INN)
unnamed: C30.2, U3.12 (INP)

Notes on the sheet:
Optional resistive attenuation network
Note: Connect pin 8 to the thermal pad
Space to put higher order filter if desired

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
