FYDP-Group-31/PCBs/Amplifier_board/Amplifier_board.kicad_pcb

## KiCad design Amplifier_board/Amplifier_board.kicad_pcb (continued)

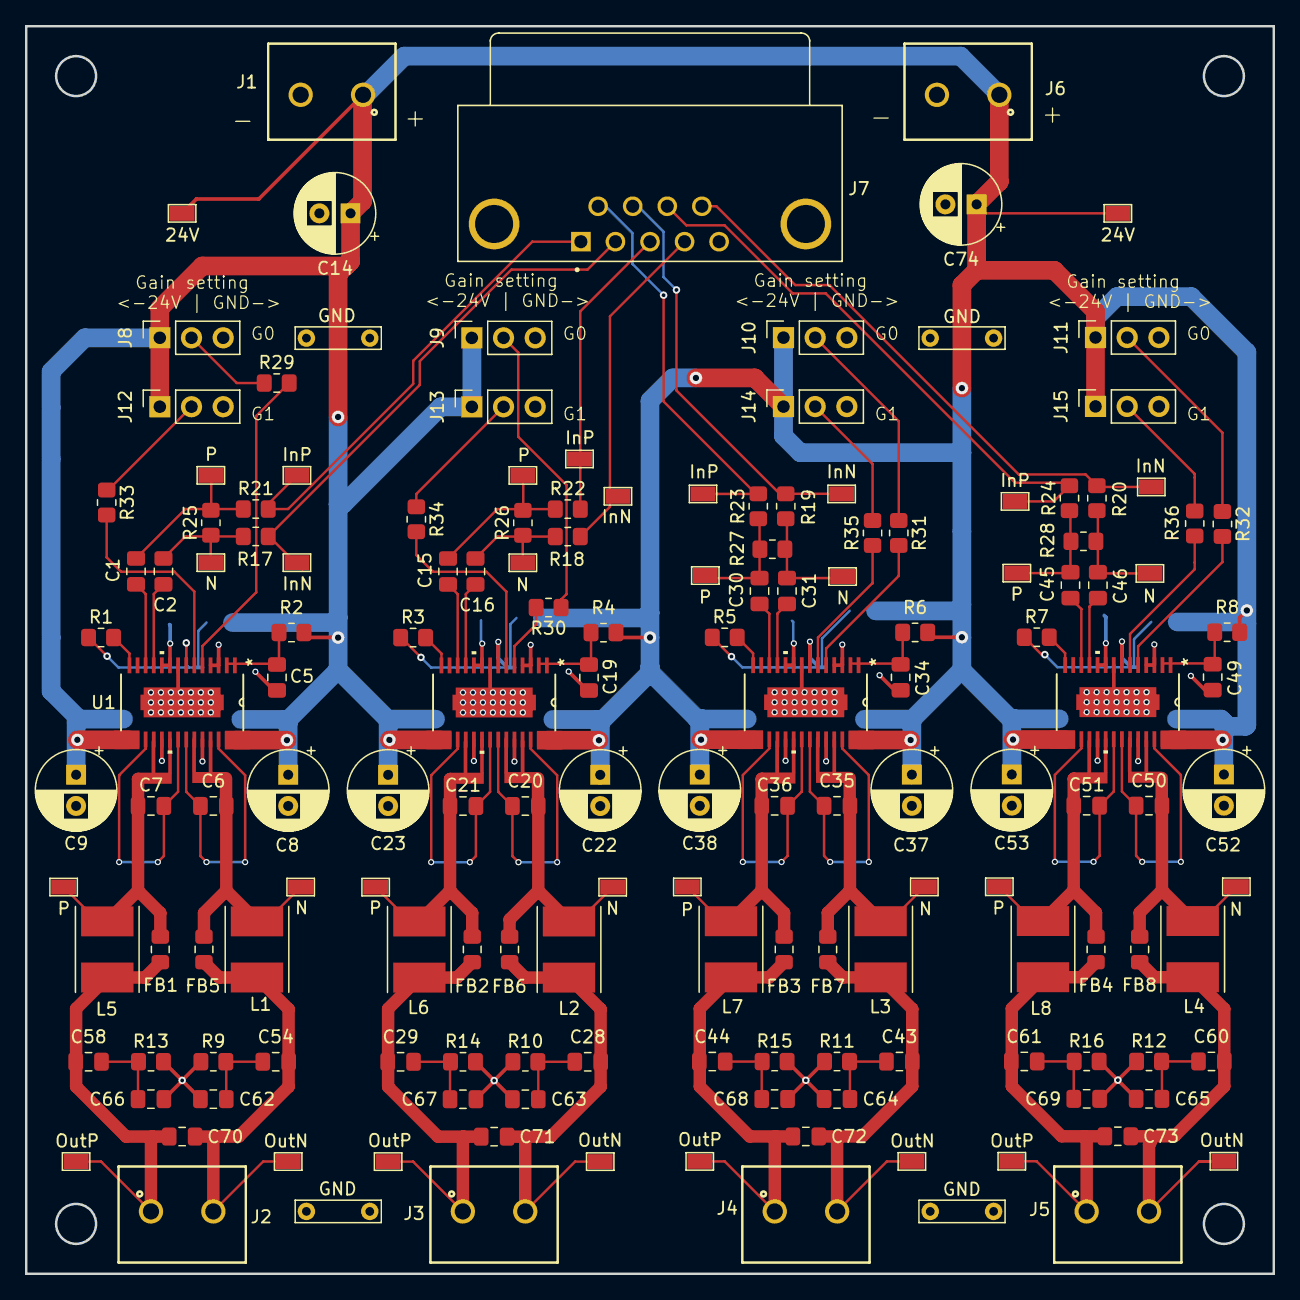
[picture p7: board Amplifier_board.kicad_pcb from above]

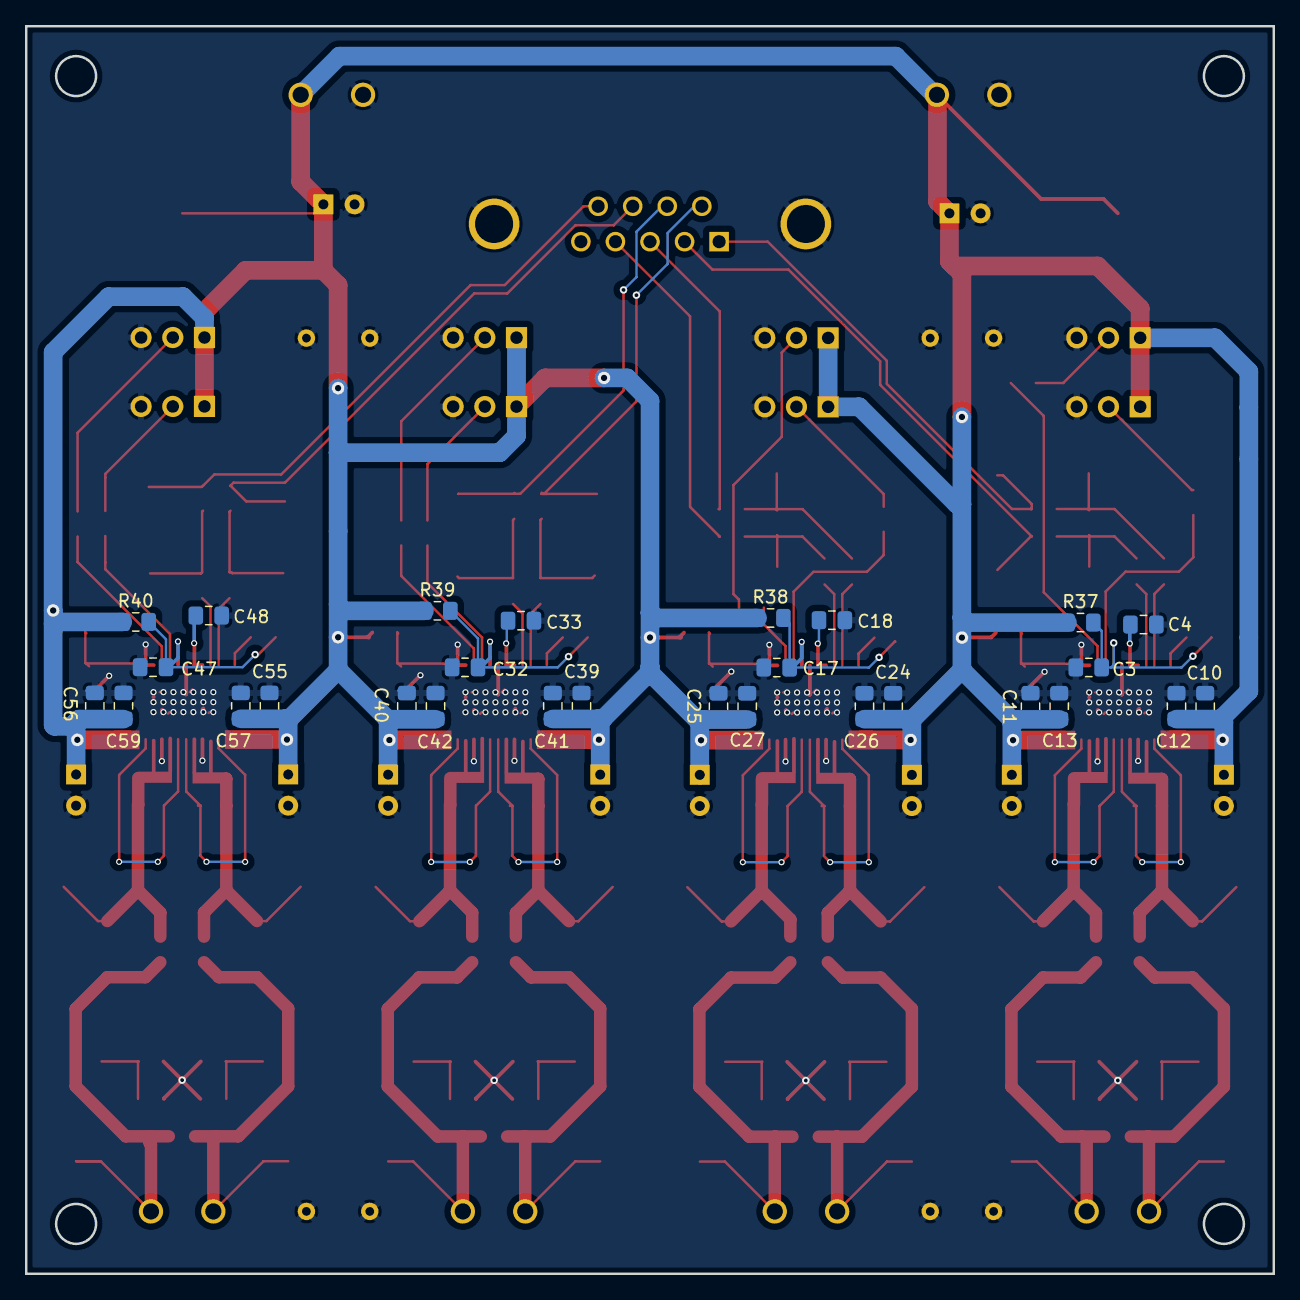
[picture p8: board Amplifier_board.kicad_pcb from below]

Board: 2 copper layers, 100.0 x 100.0 mm, 187 parts (28 on the bottom side), 90 nets.
