FYDP-Group-31/PCBs/(commit log)

2025-06-08 Added KiCad Files
    [Amplifier_board.kicad_pcb, Amplifier_board.kicad_sch, MCU_DAC_board.kicad_pcb, MCU_DAC_board.kicad_sch]
2025-06-12 Added MCU dev board, connected power pins of DAC
    [MCU_DAC_board.kicad_sch]
2025-06-23 Rough draft of amp board schematics
    [Amplifier_board.kicad_sch, amp.kicad_sch]
2025-06-23 Added buffers at DAC outputs
    [Amplifier_board.kicad_sch, MCU_DAC_board.kicad_sch, amp.kicad_sch, buffer.kicad_sch]
2025-06-26 Added 2.5V regulator circuit, jumpers on buffers
    [Amplifier_board.kicad_sch, MCU_DAC_board.kicad_sch, amp.kicad_sch, buffer.kicad_sch]
2025-06-28 Added filtering between DAC and amp, power receptacles
    [MCU_DAC_board.kicad_sch, buffer.kicad_sch]
2025-07-02 Added footprints for amplifier board
    [Amplifier_board.kicad_sch, amp.kicad_sch]
2025-07-03 Started layout of amplifier board
    [Amplifier_board.kicad_pcb, Amplifier_board.kicad_sch, amp.kicad_sch]
2025-07-03 More progress on layout
    [Amplifier_board.kicad_pcb, Amplifier_board_BOM.csv, amp.kicad_sch]
2025-07-03 More routing on amp board
    [Amplifier_board.kicad_pcb, amp.kicad_sch]
2025-07-04 Removed buffers on DAC board
    [Amplifier_board.kicad_pcb, Amplifier_board.kicad_sch, MCU_DAC_board.kicad_sch, amp.kicad_sch, buffer.kicad_sch]
2025-07-04 Added test points, almost finished layout for amp board
    [Amplifier_board.kicad_pcb, Amplifier_board.kicad_sch, amp.kicad_sch]
2025-07-05 Updated silkscreen on amp board
    [Amplifier_board.kicad_pcb]
2025-07-07 Added new MCU board footprint and symbol
    [Amplifier_board.kicad_pcb, MCU_DAC_board.kicad_sch]
2025-07-07 Schematic almost done on DAC board
    [Amplifier_board.kicad_pcb, MCU_DAC_board.kicad_sch, amp.kicad_sch]
2025-07-09 Added ferrites to amp board
    [Amplifier_board.kicad_pcb, amp.kicad_sch]
2025-07-10 Started layout of ADAU1966 area
    [MCU_DAC_board.kicad_sch, dac_filter.kicad_sch]
2025-07-10 Separated AVDD and PVDD on amplifier board
    [Amplifier_board.kicad_pcb, MCU_DAC_board.kicad_pcb, amp.kicad_sch]
2025-07-11 Finished layout for DAC board with 1 MCU
    [MCU_DAC_board.kicad_pcb, MCU_DAC_board.kicad_sch, dac_filter.kicad_sch]
